sleander1/DG5/PCB/DG5PartsPlacement3.jpg

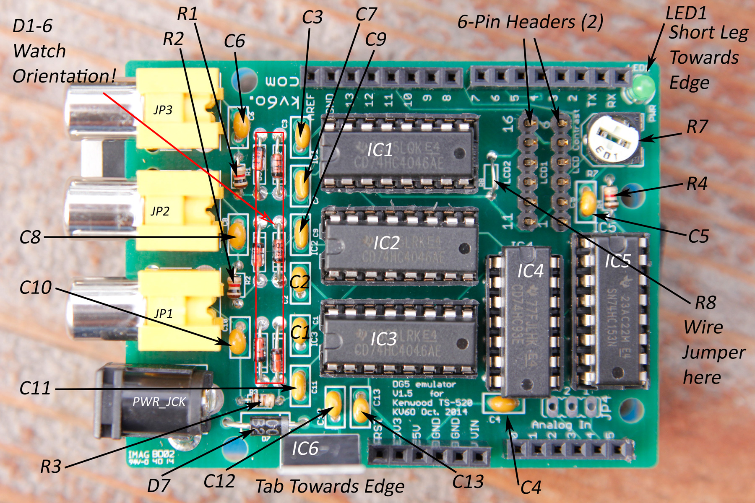
PCB/DG5PartsPlacement3.jpg
