sleander1/DG5/README.md

# DG5
An Arduino based, Kenwood DG5 emulator for the TS-520S

For more info, see http://www.kv6o.com/wordpress/projects/kenwood-dg5-emulator/
