sleander1/DG5/LED/Chassis bottom 4 hole PCB template.dxf

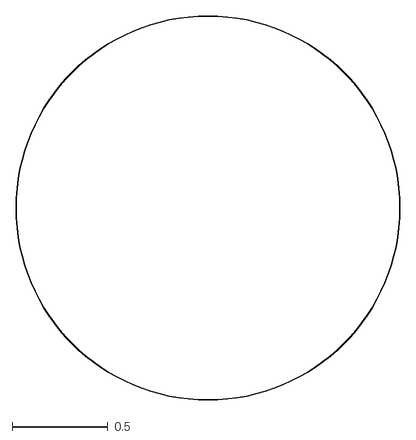
[picture p2: CAD file, 2025-05-10]
LED/Chassis bottom 4 hole PCB template.dxf
2.00 x 2.00
