sleander1/DG5/LED/FrontPlate-M3-LED-mount.stl

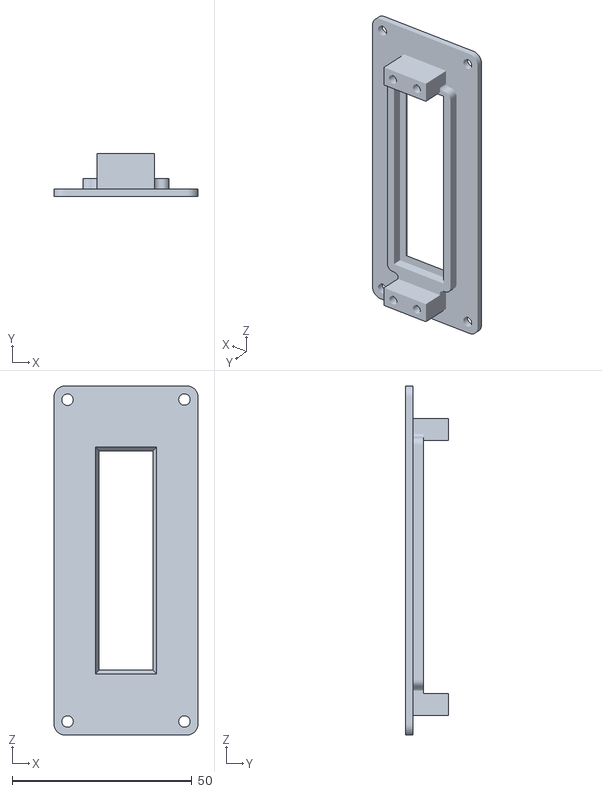
[picture p3: CAD file, 2025-05-10]
LED/FrontPlate-M3-LED-mount.stl
40.0 x 11.9 x 97.0
