sleander1/DG5/(list of files, cad)

Other CAD files:
LED/DG5-backplate.dxf
