sleander1/DG5/PCB/DG5-V2.0.3 schematic.pdf

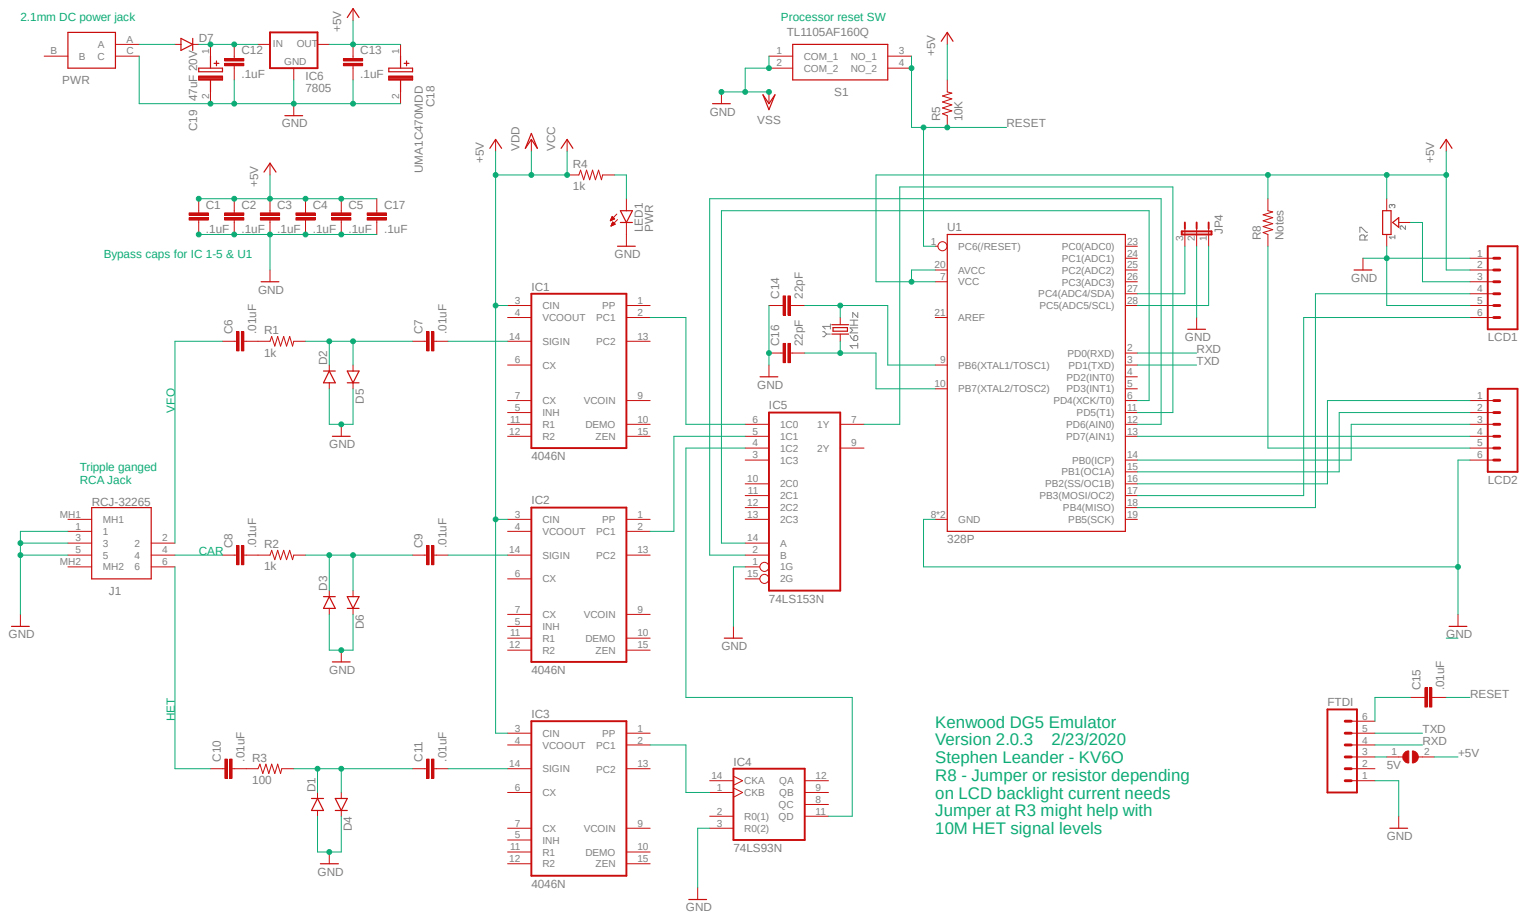
[picture p4: page 1]

Bypass caps for IC 1-5 & U1

10M HET signal levels VFO

Kenwood DG5 Emulator
Version 2.0.3 2/23/2020
Stephen Leander - KV6O
R8 - Jumper or resistor depending
on LCD backlight current needs
Jumper at R3 might help with
