sleander1/DG5/PCB/DG5-shield_v1_5.pdf

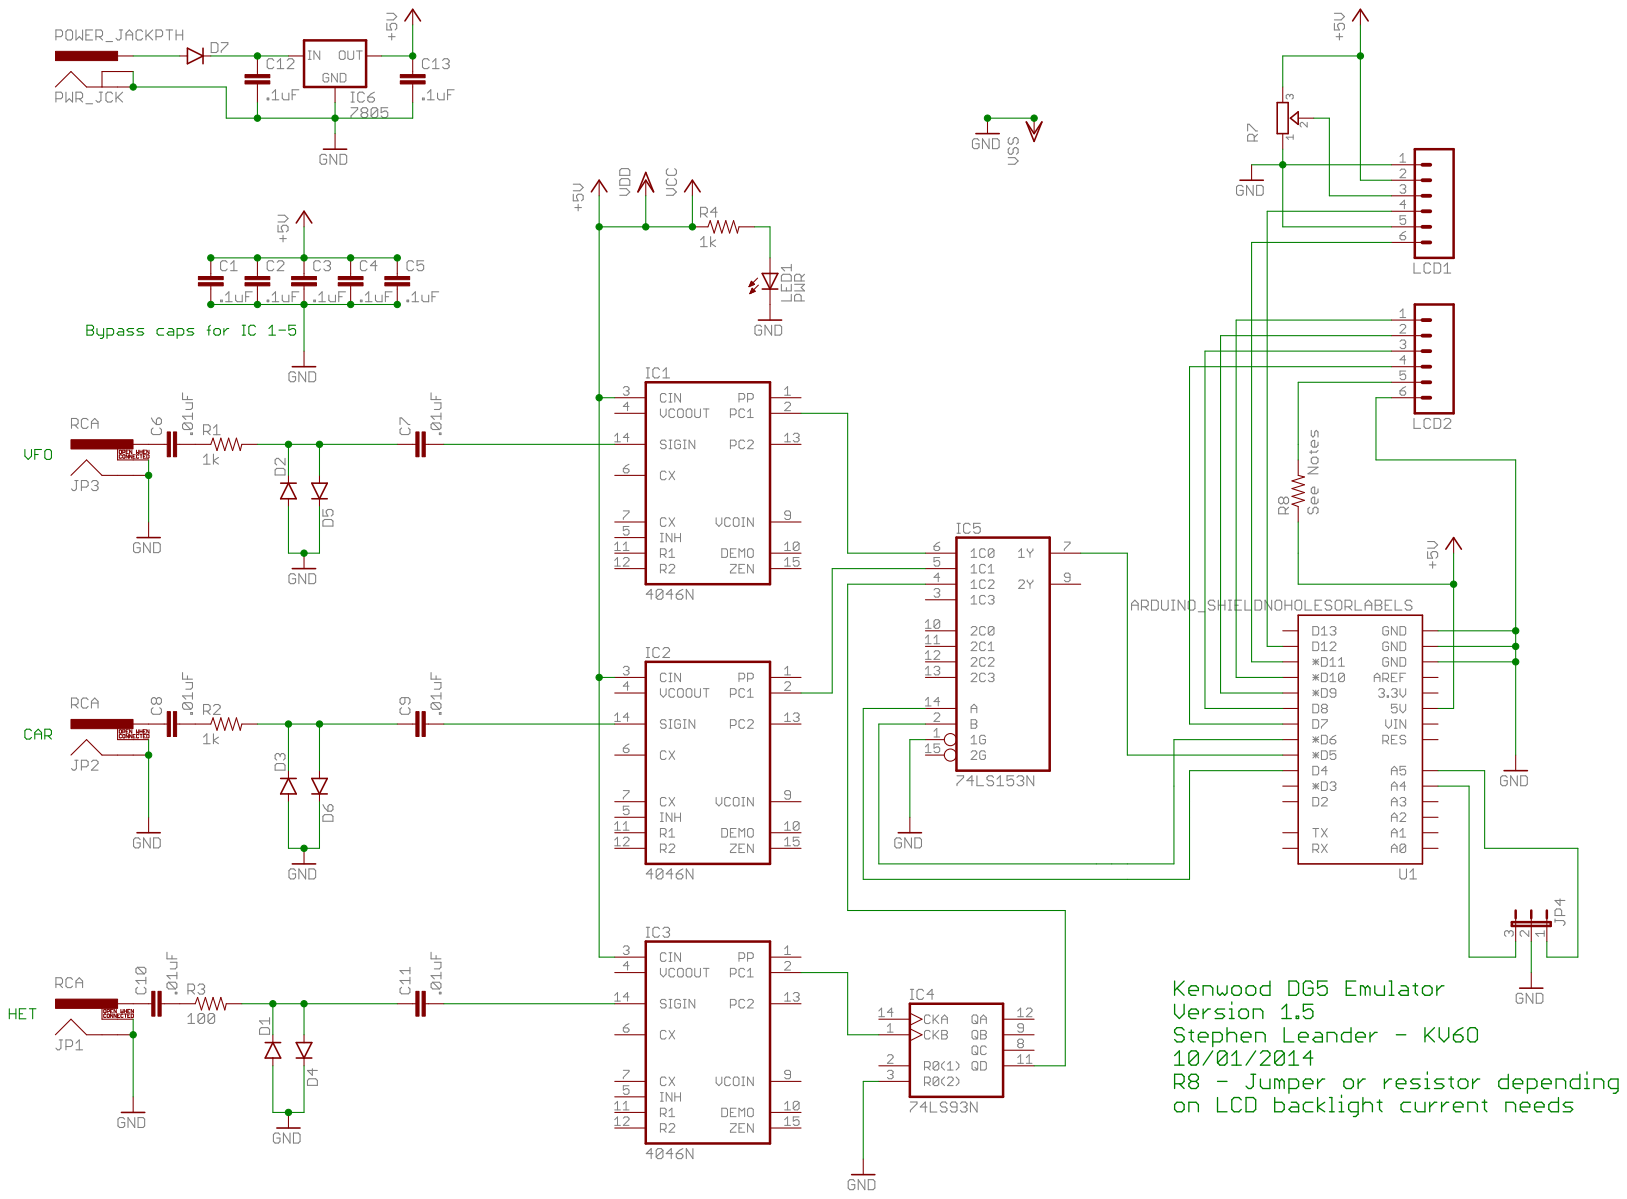
[picture p5: page 1]
