sleander1/DG5/PCB/DG5v2_0_3.brd

## EAGLE design PCB/DG5v2_0_3.brd (2020-03-09)

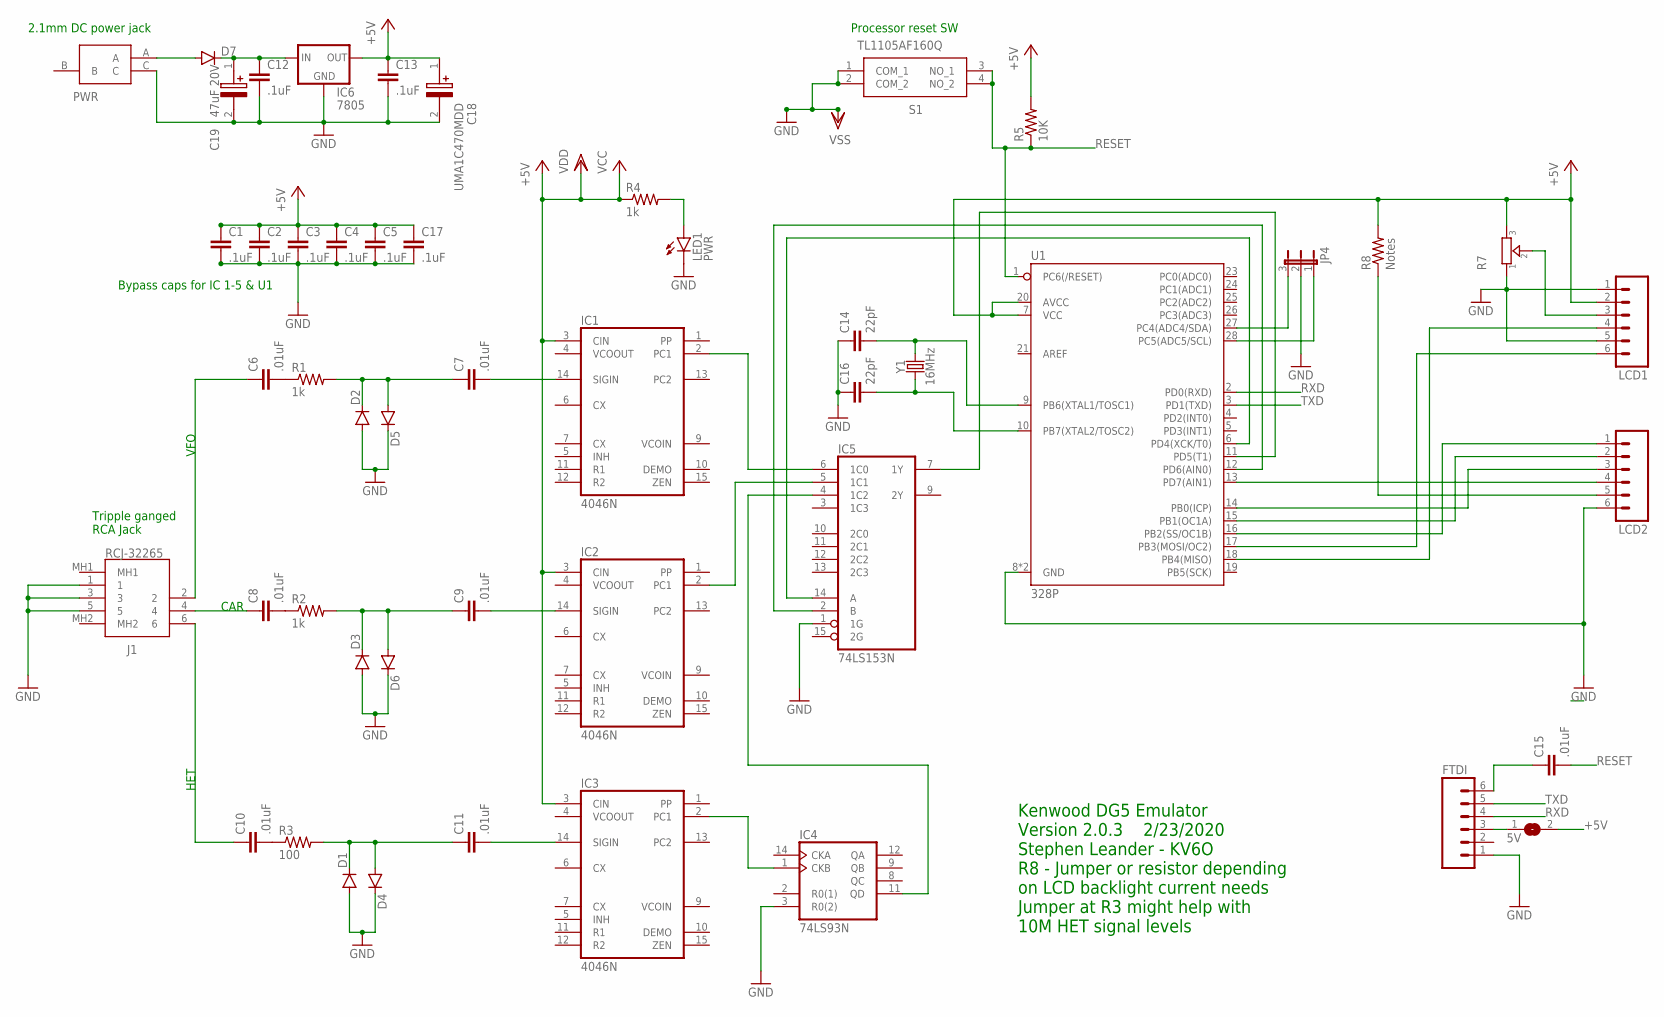
[picture p6: schematic DG5v2_0_3.sch]

Parts:
5V: SJ
C1, C2, C3, C4, C5, C12, C13, C17: .1uF; CAP-PTH-SMALL-KIT
C6, C7, C8, C9, C10, C11, C15: .01uF; CAP-PTH-SMALL-KIT
C14, C16: 22pF; CAP-PTH-SMALL
C18: UMA1C470MDD; CAPPRD250W45D680H600
C19: 47uF 20V; CAPPRD250W45D680H600
D1, D2, D3, D4, D5, D6: DIODE1N4148; DIODE-1N4148
D7: DIODE; DIODE-1N4001-KIT
FTDI: M06SIP; 1X06
IC1, IC2, IC3: 4046N; DIL16
IC4: 74LS93N; DIL14
IC5: 74LS153N; DIL16
IC6: 7805; TO220-IGO
J1: RCJ-32265; RCJ32265
JP4: JP2E; JP2
LCD1, LCD2: M06SIP; 1X06
LED1: PWR; LED3MM
PWR: 163-179PH-EX; 163179PHEX
R1, R2, R4: 1k; 1/6W-RES
R3: 100; 1/6W-RES
R5: 10K; 1/6W-RES
R7: TRIMMER-3306F; TRIMMER_3306F
R8: Notes; 1/6W-RES
S1: TL1105AF160Q
U1: 328P; DIP28
Y1: 16MHz; HC49US

Connections:
+5V: 5V.2, C1.1, C2.1, C3.1, C4.1, C5.1, C13.1, C17.1, C18.1 (+), IC1.3 (CIN), IC1.16 (VDD), IC2.3 (CIN), IC2.16 (VDD), IC3.3 (CIN), IC3.16 (VDD), IC4.5 (VCC), IC5.16 (VCC), IC6.OUT, LCD1.2, R4.1, R5.2, R7.3, R8.2, U1.7 (VCC), U1.20 (AVCC)
CAR: C8.1, J1.4
GND: C1.2, C2.2, C3.2, C4.2, C5.2, C12.2, C13.2, C14.1, C16.1, C17.2, C18.2 (-), C19.2 (-), D1.A, D2.A, D3.A, D4.C, D5.C, D6.C, FTDI.1, IC1.8 (VSS), IC2.8 (VSS), IC3.8 (VSS), IC4.3 (R0(2)), IC4.10 (GND), IC5.1 (1G), IC5.8 (GND), IC6.GND, J1.1, J1.3, J1.5, JP4.2, LCD1.1, LCD1.5, LCD2.6, LED1.K (C), PWR.C, R7.1, S1.1 (COM_1), S1.2 (COM_2), U1.8 (GND), U1.22 (GND)
HET: C10.1, J1.6
unnamed: C7.2, IC1.14 (SIGIN)
unnamed: IC1.2 (PC1), IC5.6 (1C0)
unnamed: IC2.2 (PC1), IC5.5 (1C1)
unnamed: C8.2, R2.1
unnamed: C6.2, R1.1
unnamed: C7.1, D2.C, D5.A, R1.2
unnamed: IC3.2 (PC1), IC4.1 (CKB)
unnamed: IC4.11 (QD), IC5.4 (1C2)
unnamed: C9.1, D3.C, D6.A, R2.2
unnamed: 5V.1, FTDI.3
unnamed: C9.2, IC2.14 (SIGIN)
unnamed: C11.2, IC3.14 (SIGIN)
unnamed: C11.1, D1.C, D4.A, R3.2
unnamed: C10.2, R3.1
unnamed: IC5.7 (1Y), U1.11 (PD5(T1))
unnamed: IC5.2 (B), U1.12 (PD6(AIN0))
unnamed: IC5.14 (A), U1.6 (PD4(XCK/T0))
unnamed: C14.2, U1.9 (PB6(XTAL1/TOSC1)), Y1.2
unnamed: LED1.A, R4.2
unnamed: JP4.3, U1.27 (PC4(ADC4/SDA))
unnamed: JP4.1, U1.28 (PC5(ADC5/SCL))
unnamed: C16.2, U1.10 (PB7(XTAL2/TOSC2)), Y1.1
unnamed: LCD2.5, R8.1
unnamed: LCD1.3, R7.2
unnamed: LCD1.4, U1.18 (PB4(MISO))
unnamed: LCD1.6, U1.17 (PB3(MOSI/OC2))
unnamed: C15.1, FTDI.6
unnamed: D7.A, PWR.A
unnamed: LCD2.1, U1.16 (PB2(SS/OC1B))
unnamed: LCD2.2, U1.15 (PB1(OC1A))
unnamed: LCD2.3, U1.14 (PB0(ICP))
unnamed: LCD2.4, U1.13 (PD7(AIN1))
RESET: C15.2, R5.1, S1.3 (NO_1), S1.4 (NO_2), U1.1 (PC6(/RESET))
RXD: FTDI.4, U1.2 (PD0(RXD))
TXD: FTDI.5, U1.3 (PD1(TXD))
VFO: C6.1, J1.2
VIN: C12.1, C19.1 (+), D7.C, IC6.IN

Notes on the sheet:
Kenwood DG5 Emulator Version 2.0.3 2/23/2020 Stephen Leander - KV6O R8 - Jumper or resistor depending on LCD backlight current needs Jumper at R3 might help with 10M HET signal levels
VFO
CAR
HET
Bypass caps for IC 1-5 & U1
Tripple ganged RCA Jack
2.1mm DC power jack
Processor reset SW

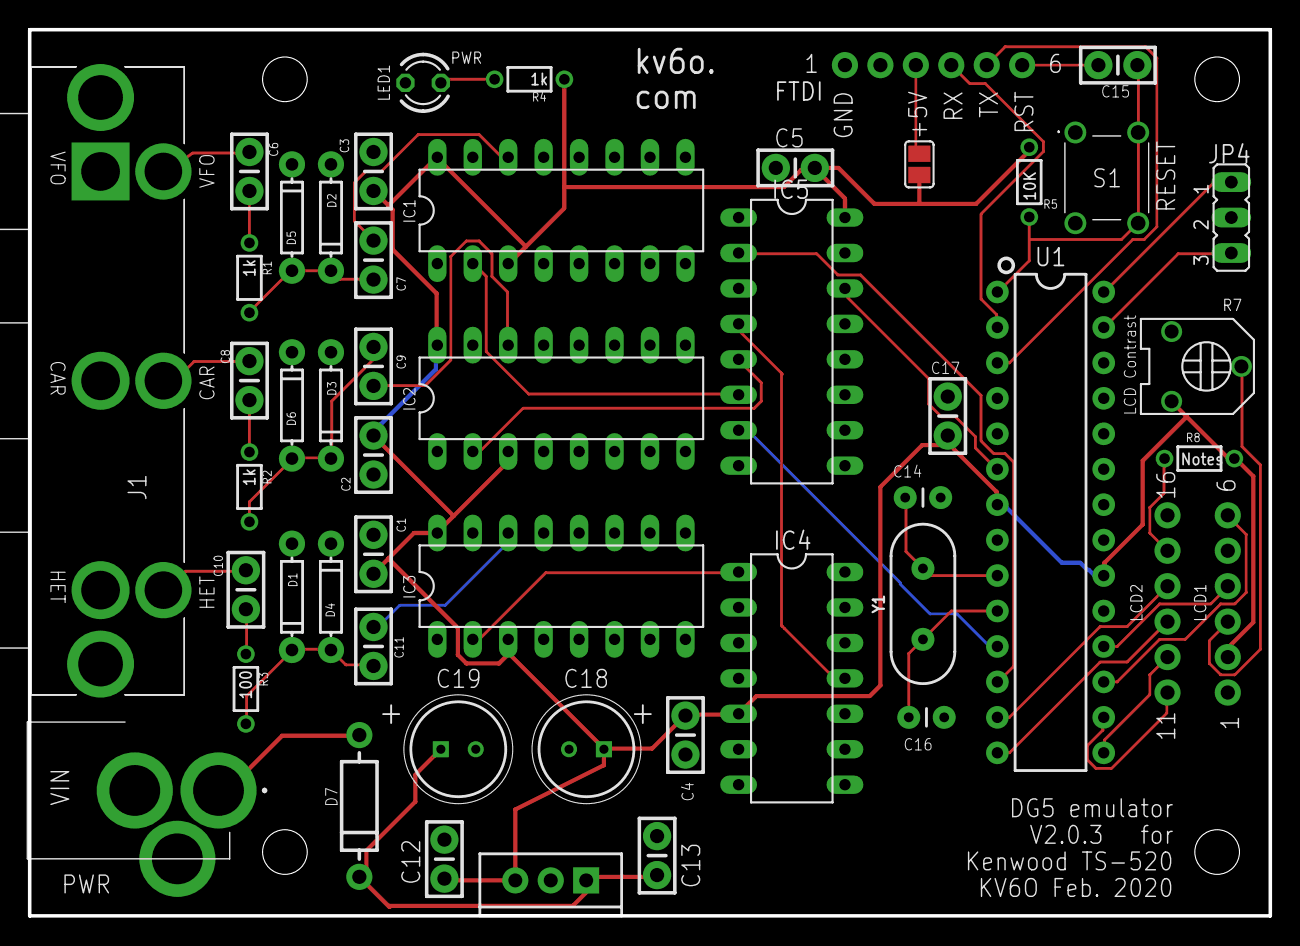
[picture p7: board DG5v2_0_3.brd from above]

Board: 2 copper layers, 88.9 x 63.5 mm, 50 parts (0 on the bottom side), 41 nets.
